codingABI/DCF77voiceClock/DCF77voiceClock/audioSamples.h

// Audio sample definitions
#pragma once

// Voice: 0
#define AUDIO_0 0

// Voice: 1
#define AUDIO_1 1

// Voice: 2
#define AUDIO_2 2

// Voice: 3
#define AUDIO_3 3

// Voice: 4
#define AUDIO_4 4

// Voice: 5
#define AUDIO_5 5

// Voice: 6
#define AUDIO_6 6

// Voice: 7
#define AUDIO_7 7

// Voice: 8
#define AUDIO_8 8

// Voice: 9
#define AUDIO_9 9

// Voice: 10
#define AUDIO_10 10

// Voice: 11
#define AUDIO_11 11

// Voice: 12
#define AUDIO_12 12

// Voice: 13
#define AUDIO_13 13

// Voice: 14
#define AUDIO_14 14

// Voice: 15
#define AUDIO_15 15

// Voice: 16
#define AUDIO_16 16

// Voice: 17
#define AUDIO_17 17

// Voice: 18
#define AUDIO_18 18

// Voice: 19
#define AUDIO_19 19

// Voice: 20
#define AUDIO_20 20

// Voice: 21
#define AUDIO_21 21

// Voice: 22
#define AUDIO_22 22

// Voice: 23
#define AUDIO_23 23

// Voice: 24
#define AUDIO_24 24

// Voice: 25
#define AUDIO_25 25

// Voice: 26
#define AUDIO_26 26

// Voice: 27
#define AUDIO_27 27

// Voice: 28
#define AUDIO_28 28

// Voice: 29
#define AUDIO_29 29

// Voice: 30
#define AUDIO_30 30

// Voice: 31
#define AUDIO_31 31

// Voice: 32
#define AUDIO_32 32

// Voice: 33
#define AUDIO_33 33

// Voice: 34
#define AUDIO_34 34

// Voice: 35
#define AUDIO_35 35

// Voice: 36
#define AUDIO_36 36

// Voice: 37
#define AUDIO_37 37

// Voice: 38
#define AUDIO_38 38

// Voice: 39
#define AUDIO_39 39

// Voice: 40
#define AUDIO_40 40

// Voice: 41
#define AUDIO_41 41

// Voice: 42
#define AUDIO_42 42

// Voice: 43
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
#define AUDIO_25th 153

// Voice: 26th
#define AUDIO_26th 154

// Voice: 27th
#define AUDIO_27th 155

// Voice: 28th
#define AUDIO_28th 156

// Voice: 29th
#define AUDIO_29th 157

// Voice: 30th
#define AUDIO_30th 158

// Voice: 31st
#define AUDIO_31st 159

// Voice: One
#define AUDIO_ONE 160

// Voice: oclock
#define AUDIO_OCLOCK 161

// Voice: o1
#define AUDIO_01 162

// Voice: o2
#define AUDIO_02 163

// Voice: o3
#define AUDIO_03 164

// Voice: o4
#define AUDIO_04 165

// Voice: o5
#define AUDIO_05 166

// Voice: o6
#define AUDIO_06 167

// Voice: o7
#define AUDIO_07 168

// Voice: o8
#define AUDIO_08 169

// Voice: o9
#define AUDIO_09 170

// Voice: January
#define AUDIO_JANUARY 171

// Voice: February
#define AUDIO_FEBRUARY 172

// Voice: March
#define AUDIO_MARCH 173

// Voice: April
#define AUDIO_APRIL 174

// Voice: May
#define AUDIO_MAY 175

// Voice: June
#define AUDIO_JUNE 176

// Voice: July
#define AUDIO_JULY 177

// Voice: August
#define AUDIO_AUGUST 178

// Voice: September
#define AUDIO_SEPTEMBER 179

// Voice: October
#define AUDIO_OCTOBER 180

// Voice: November
#define AUDIO_NOVEMBER 181

// Voice: December
#define AUDIO_DECEMBER 182

// Voice: Sunday
#define AUDIO_SUNDAY 183

// Voice: Monday
#define AUDIO_MONDAY 184

// Voice: Tuesday
#define AUDIO_TUESAY 185

// Voice: Wednesday
#define AUDIO_WEDNESDAY 186

// Voice: Thursday
#define AUDIO_THURSDAY 187

// Voice: Friday
#define AUDIO_FRIDAY 188

// Voice: Saturday
#define AUDIO_SATURDAY 189

// Voice: Turn the knob to change the value. The value is accepted by finally pressing the knob. If the knob is not pressed, the change is automatically canceled after one minute.
#define AUDIO_EDITTIME 190

// Voice: Turn the knob to change. Press the knob again to accept the new volume level. If the knob is not pressed, the volume change is automatically canceled after one minute.
#define AUDIO_EDITVOLUME 191

// Voice: To select a time unit, turn the knob and press to confirm
#define AUDIO_CHANGETIMEDESC 192

// Voice: Done
#define AUDIO_DONE 193

// Voice: Canceled
#define AUDIO_ABORTED 194

// Voice: Cancel
#define AUDIO_ABORT 195

// Voice: Change time
#define AUDIO_CHANGETIME 196

// Voice: Hour
#define AUDIO_HOUR 197

// Voice: Minute
#define AUDIO_MINUTE 198

// Voice: Second
#define AUDIO_SECOND 199

// Voice: Day
#define AUDIO_DAY 200

// Voice: Month
#define AUDIO_MONTH 201

// Voice: Year
#define AUDIO_YEAR 202

// Voice: Sunrise
#define AUDIO_SUNRISE 203

// Voice: Sunset
#define AUDIO_SUNSET 204

// Voice: Start time synchronization
#define AUDIO_STARTSYNC 205

// Voice: Time synchronization can take up to 
#define AUDIO_SYNCDESC1 206

// Voice: minutes and can be cancel by pressing the knob
#define AUDIO_SYNCDESC2 207

// Voice: Time synchronization canceled
#define AUDIO_SYNCABORTED 208

// Voice: Time synchronization was successful
#define AUDIO_SYNCSUCCESS 209

// Voice: Last time synchronization failed. The time may therefore be inaccurate or incorrect
#define AUDIO_LASTSYNCFAILED 210

// Voice: Change audio volume
#define AUDIO_CHANGEVOLUME 211

// Voice: Volume
#define AUDIO_VOLUME 212

// Voice: Operating voltage
#define AUDIO_VCC 213

// Voice: Volt
#define AUDIO_VOLT 214

// Voice: Dot
#define AUDIO_DOT 215

// Voice: Clock
#define AUDIO_CLOCK 216

// Voice: Complete time announcement
#define AUDIO_COMPLETETIME 217

// Voice: Main menu
#define AUDIO_MAINMENU 218

// Voice: To select a menu item, turn the knob and press to confirm
#define AUDIO_MAINMENUDESC 219

// Voice: Current selection
#define AUDIO_CURRENTITEM 220

// Voice: Exit main menu
#define AUDIO_MAINMENUEXIT 221

// Voice: Main menu exited
#define AUDIO_MAINMENUEXITED 222

// Voice: Back to main menu
#define AUDIO_BACK 223

// Voice: Change language
#define AUDIO_CHANGELANGUAGE 224

// Voice: Language
#define AUDIO_LANGUAGE 225

// Voice: Press the knob to change the language
#define AUDIO_LANGUAGEEDIT 226

// Voice: English
#define AUDIO_LANGUAGEEN 227

// Voice: German
#define AUDIO_LANGUAGEDE 228

// Number of voice files
#define AUDIO_MAXFILES 229
