codingABI/DCF77voiceClock/(commit log)

2024-10-27 Changes for currenttime, DCF77SYNCHOUR
    Set currenttime in loop more early
    Move DCF77SYNCHOUR from 0 to 3 to avoid problems at summer-/wintertime change
    [DCF77voiceClock.ino]
2026-04-29 Exit daily silent DCF time sync by PIR sensor interrupt
